wheeler-microfluidics/kicad___dmf_control_board/docs/png/Control board test points (front).png

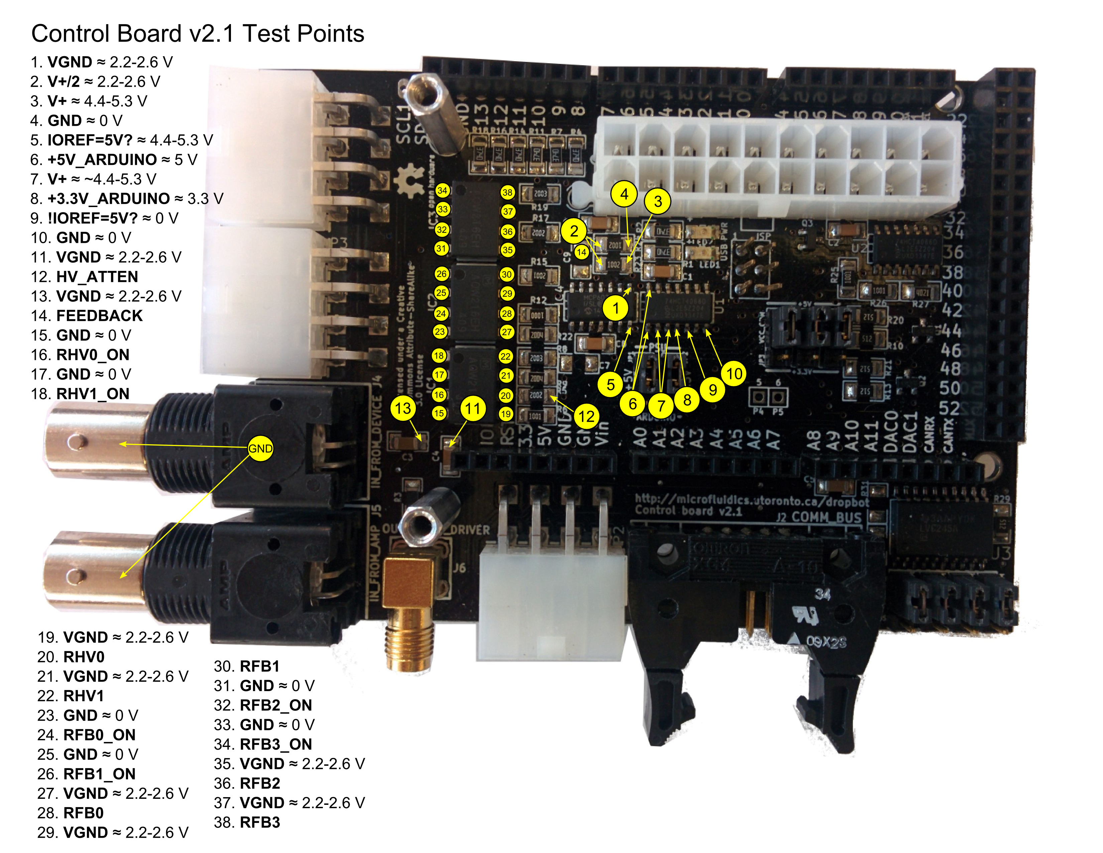
docs/png/Control board test points (front).png
