wheeler-microfluidics/kicad___dmf_control_board/docs/src/control board photo.jpg

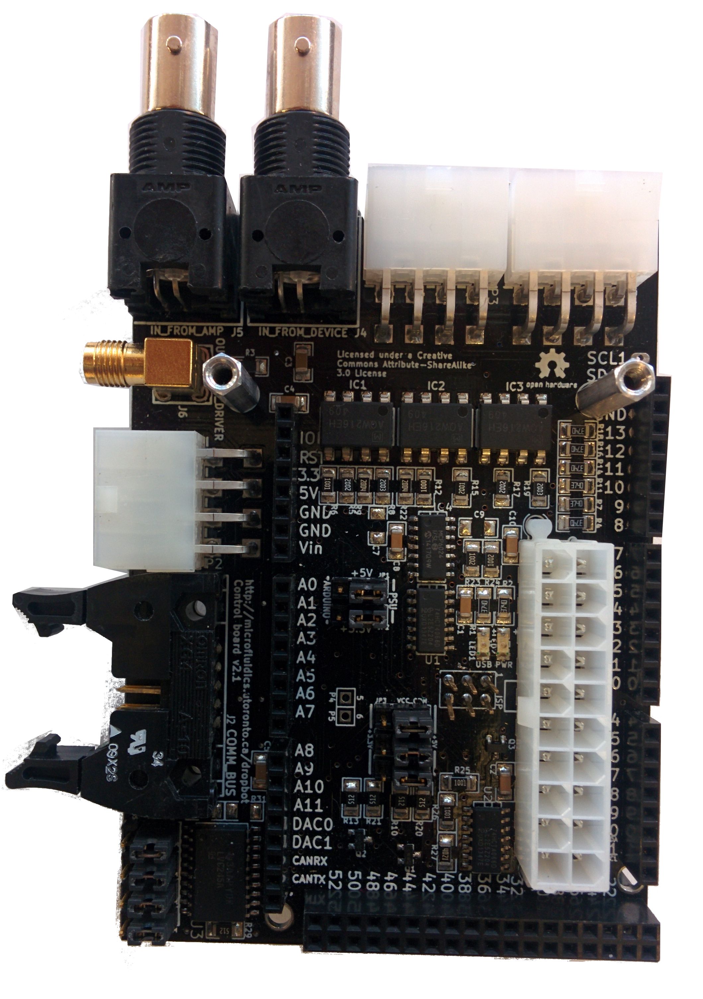
docs/src/control board photo.jpg
