wheeler-microfluidics/kicad___dmf_control_board/docs/Control board v2.1 documentation.odt

Control board v2.1

http://microfluidics.utoronto.ca/trac/dropbot/wiki/ControlBoard

Document revision: 3

Last updated: 2015-03-17
