wheeler-microfluidics/kicad___dmf_control_board/docs/png/Control board layout (back).png

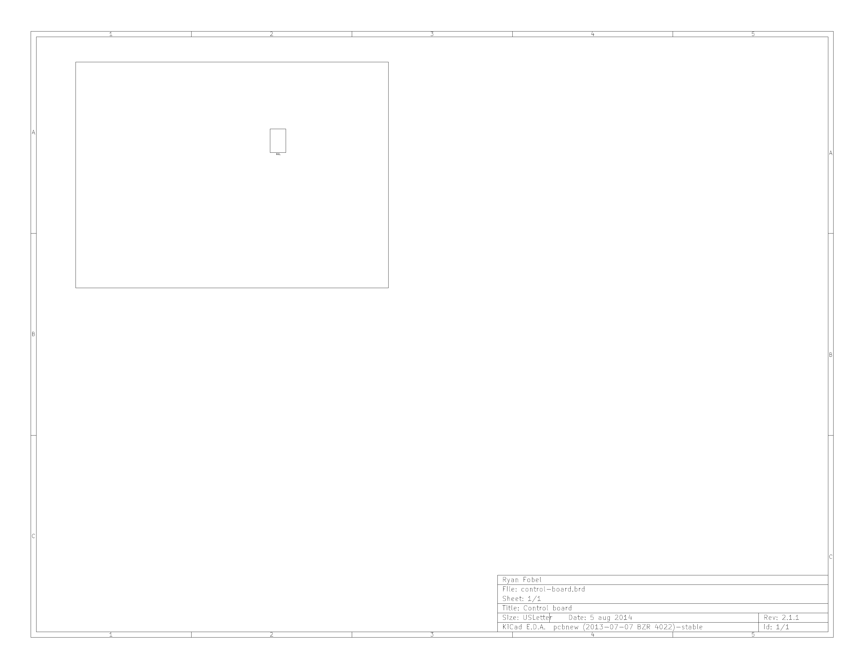
docs/png/Control board layout (back).png
