wheeler-microfluidics/kicad___dmf_control_board/docs/png/Control board layout (front).png

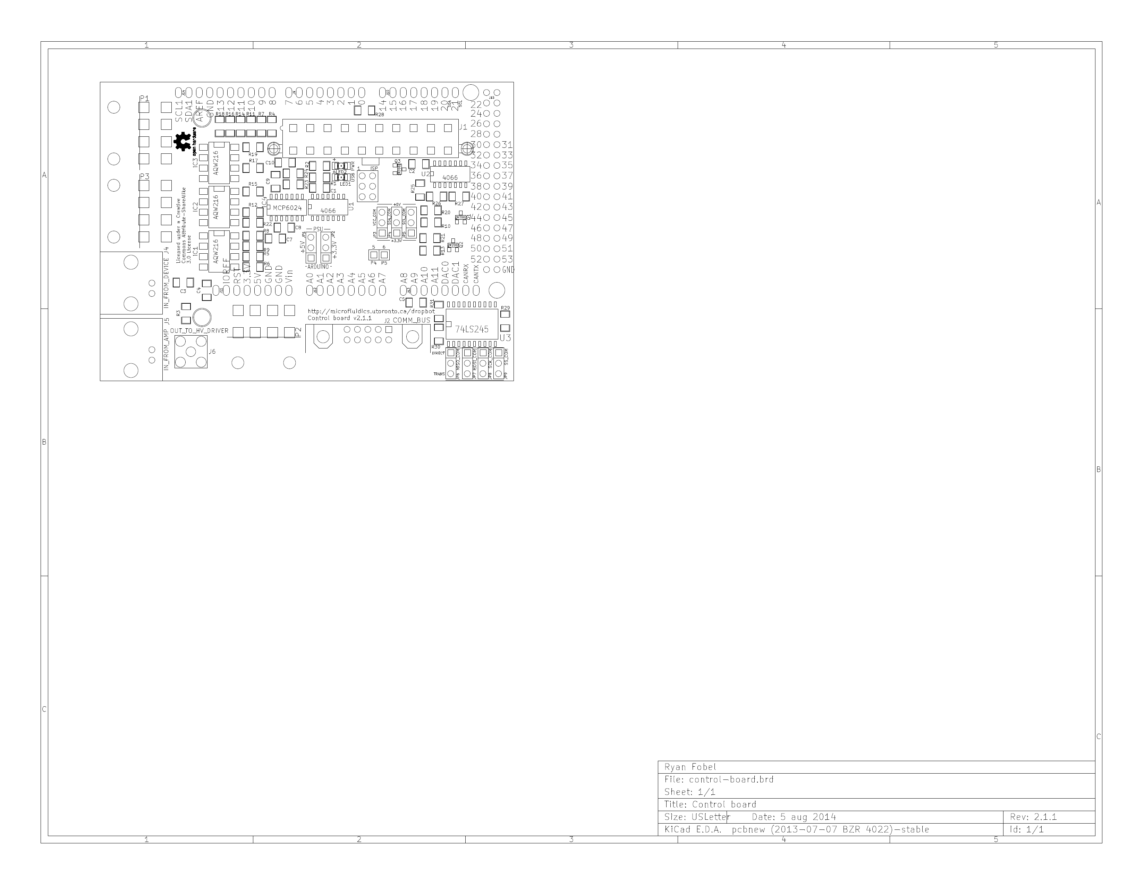
docs/png/Control board layout (front).png
