wheeler-microfluidics/kicad___dmf_control_board/docs/png/Control board schematic (p2).png

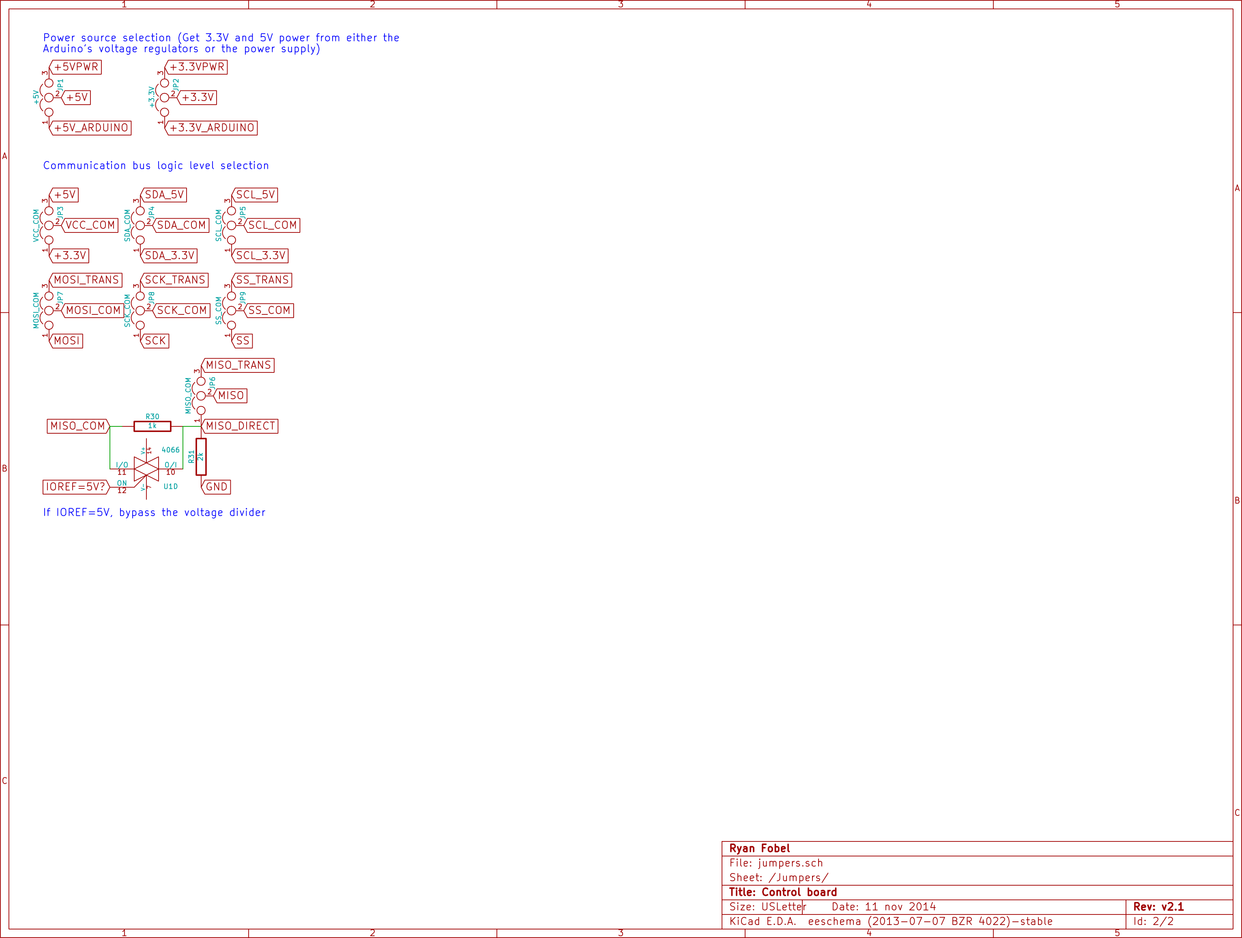
docs/png/Control board schematic (p2).png
