wheeler-microfluidics/kicad___dmf_control_board/docs/png/control-board-BOM.png

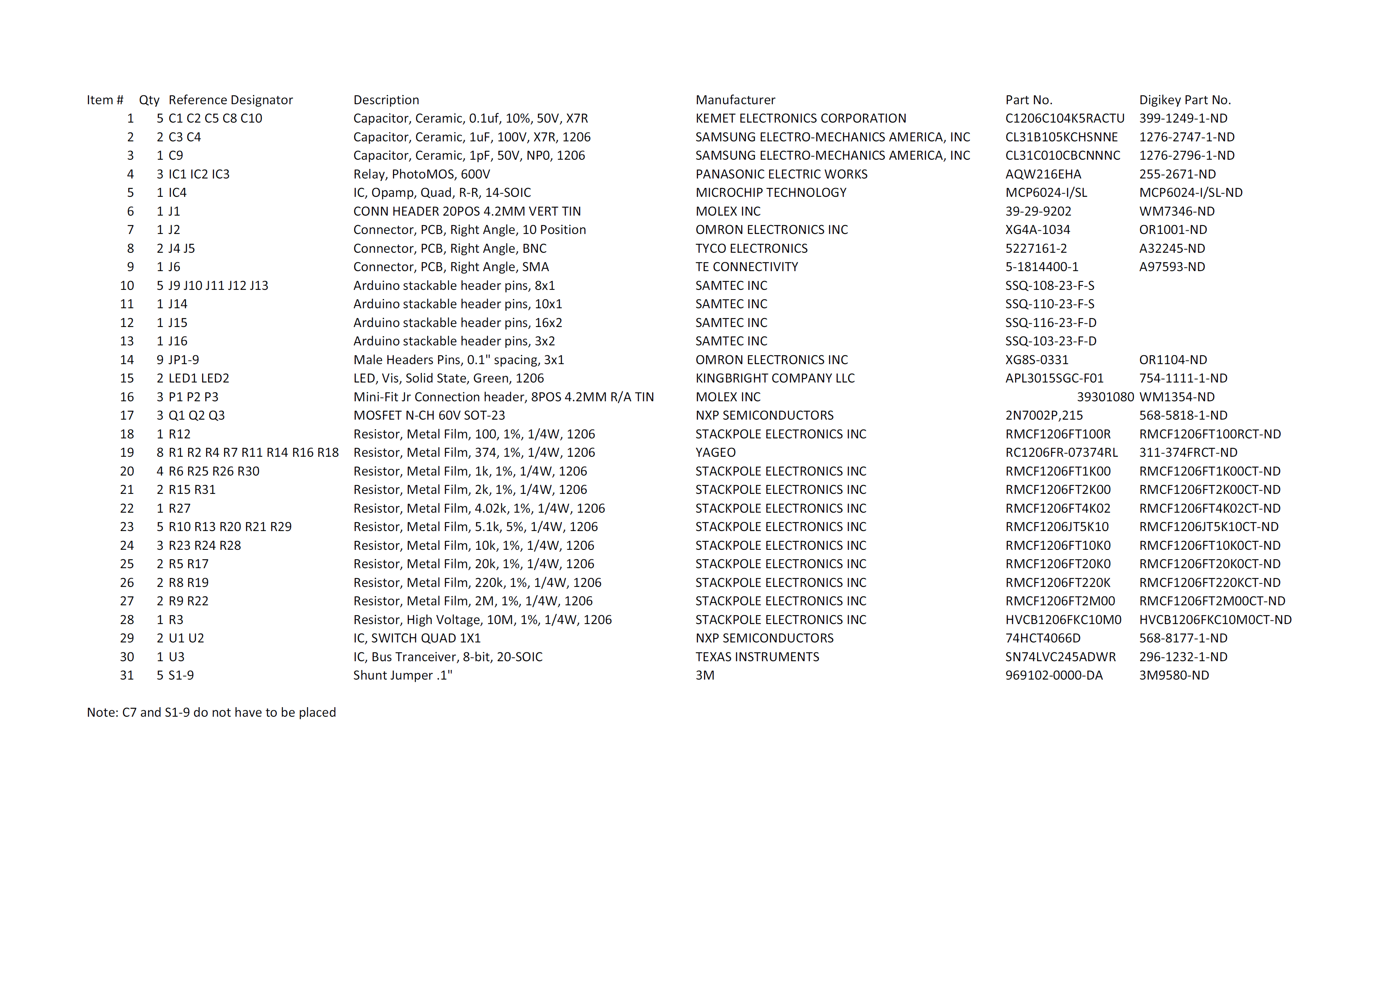
docs/png/control-board-BOM.png
