wheeler-microfluidics/kicad___dmf_control_board/docs/src/Control board layout (back).pdf

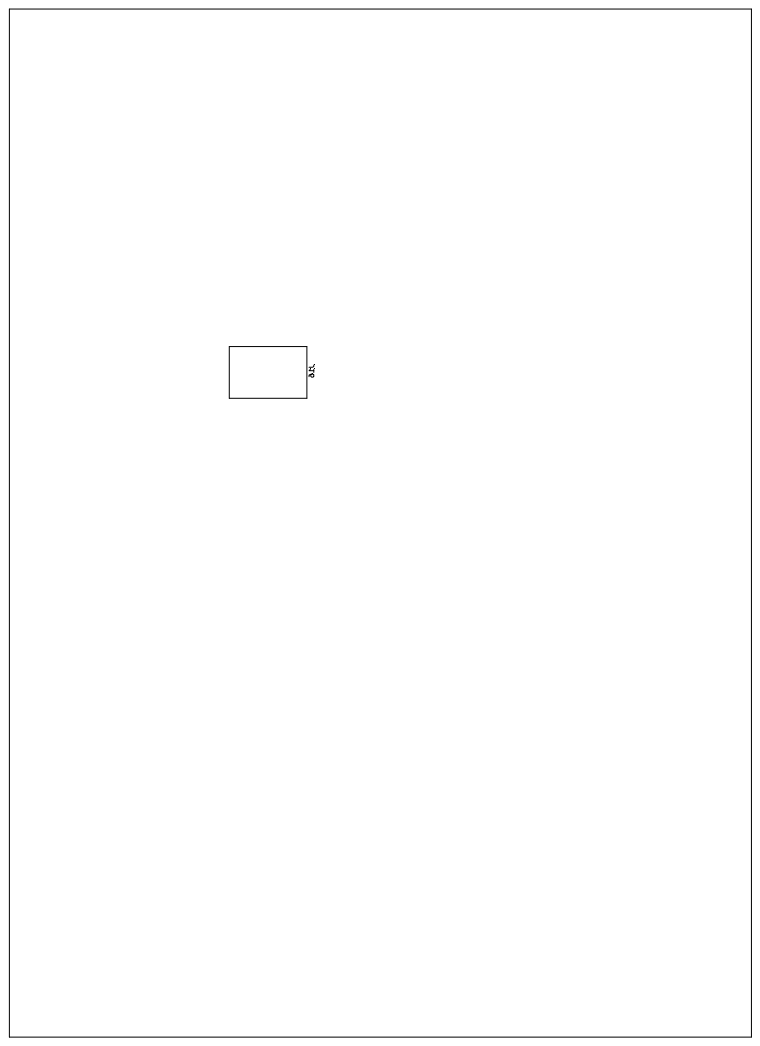
[picture p8: page 1]
