wheeler-microfluidics/kicad___dmf_control_board/docs/src/Control board layout (front).pdf

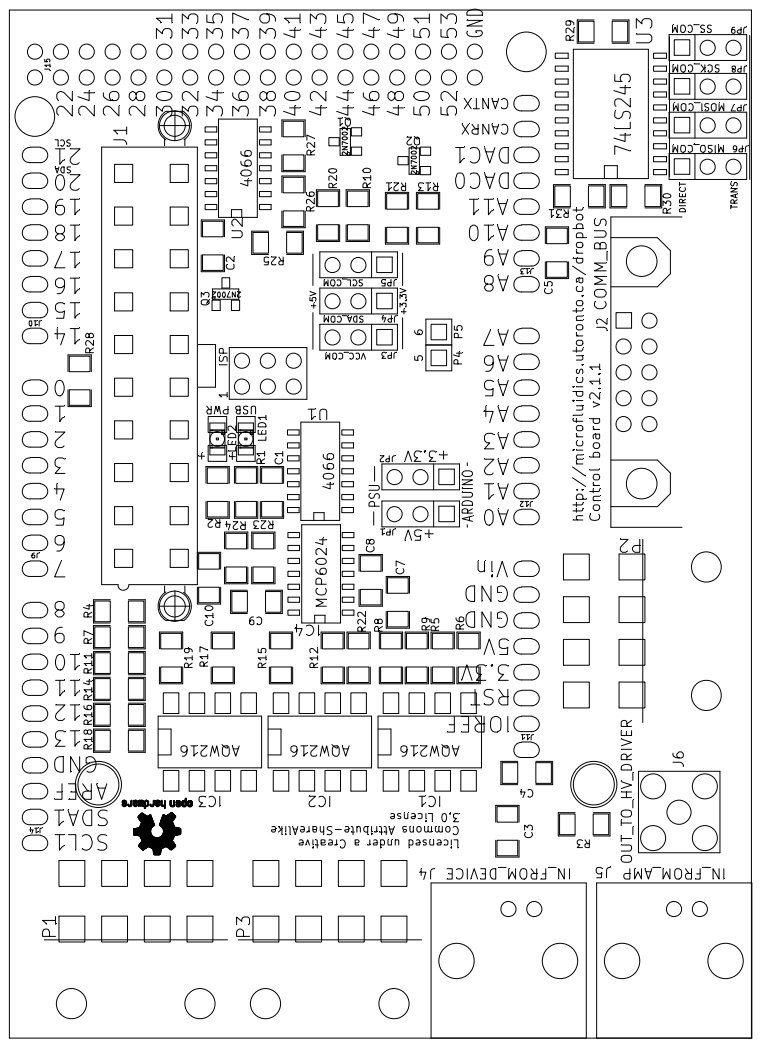
[picture p9: page 1]
