wheeler-microfluidics/kicad___dmf_control_board/control-board.sch

## KiCad design control-board.sch (2014-11-11, an earlier design)

Schematic: control-board.sch

Parts:
C1, C2, C5, C8, C10: 0.1uF
C3, C4: 1uF
C7: 5pF
C9: 1pF
IC1, IC2, IC3: AQW216
IC4: MCP6024
J1: CONN_20
J2: COMM_BUS
J4: IN_FROM_DEVICE
J5: IN_FROM_AMP
J6: OUT_TO_HV_DRIVER
LED1: USB
LED2: PWR
P1, P2, P3: CONN_8
P4: 5
P5: 6
Q1, Q2, Q3: 2N7002; SOT323
R1, R2, R4, R7, R11, R14, R16, R18: 374
R3: 10Meg
R5, R17: 20k
R6, R25, R26: 1k
R8, R19: 200k
R9, R22: 2Meg
R10, R13, R20, R21, R29: 5.1k
R12: 100
R15: 2k
R23, R24, R28: 10k
R27: 4k
SHIELD1: ARDUINO_DUE_SHIELD
U1, U2: 4066
U3: 74LS245

Notes on the sheet:
Power supply connection
BNC connections
600V resistor
Feedback resistor selection
Communication bus
Arduino Mega 2560/Due
Power bus
i2c level shifting
Jumpers
If IOREF > 4V, assume +5V, otherwise, +3.3V logic levels
SPI level shifting
