wheeler-microfluidics/kicad___dmf_control_board/jumpers.sch

## KiCad design jumpers.sch (2014-11-11, an earlier design)

Schematic: jumpers.sch

Parts:
JP1: +5V
JP2: +3.3V
JP3: VCC_COM
JP4: SDA_COM
JP5: SCL_COM
JP6: MISO_COM
JP7: MOSI_COM
JP8: SCK_COM
JP9: SS_COM
R30: 1k
R31: 2k
U1: 4066

Notes on the sheet:
Power source selection (Get 3.3V and 5V power from either the Arduino's voltage regulators or the power supply)
Communication bus logic level selection
If IOREF=5V, bypass the voltage divider
