wheeler-microfluidics/kicad___dmf_control_board/(commit log)

2011-03-15 version 1.0
    [control-board BOM.xls, control-board.brd, control-board.sch]
2011-05-14 Major revision
    -fix several problems with v1.0
    -add peak detector and phase comparator
    -use digipots to set and VGND, AREF
    -allow selection of sine wave or square wave output
    [control-board BOM.xls, control-board-BOM.xls, control-board-p1.sch, control-board-p2.sch, control-board-p3.sch, control-board.brd, control-board.sch]
2011-05-14 Update pdfs.
    [control-board.brd]
2011-05-14 Add extra BNC jack to connect HV driver board
    [control-board-BOM.xls, control-board-p1.sch, control-board-p2.sch, control-board-p3.sch, control-board.brd, control-board.sch]
2011-06-01 Add C22 and C23 to BOM
    [control-board-BOM.xls]
2011-06-01 Upgrade to new version of Kicad and make diodes visible on silkscreen
    [control-board-p1.sch, control-board-p2.sch, control-board-p3.sch, control-board.brd, control-board.sch]
2011-06-01 Change 10-pin connector to a right-angle version
    [control-board-BOM.xls]
2011-07-27 Fix footprint of LM339
    [control-board-p1.sch, control-board-p2.sch, control-board-p3.sch, control-board.brd, control-board.sch]
2011-11-21 Add ATX power supply connector and mounting holes
    [control-board-BOM.xls, control-board-p1.sch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]
2011-12-16 Fix BOM (PhotoMOS part number was wrong)
    [control-board-BOM.xls]
2012-05-15 Minor adjustments to optimize performance and reduce noise
    -remove peak, phase detectors
    -remove adjustable AREF
    -remove power resistors
    -remove monitoring of WAVEOUT
    -remove bias current compensation resistors
    -try to reduce capacitance of HV and feedback traces
    [control-board-BOM.xls, control-board-p1.sch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]
2013-08-26 Lots of changes from v1 series
    -use new communication and power busses
    -break out signal generator onto separate board
    -new feedback scheme
    -jumpers to power from Arduino or PSU
    -automatically select Arduino Mega 2560 or Due (3.3V) including
    level-shifting of i2c
    [control-board-B_Mask.gbs, control-board-B_SilkS.gbo, control-board-Component.gtl, control-board-Copper.gbl, control-board-Edge_Cuts.gbr, control-board-F_Mask.gts, control-board-F_SilkS.gto, control-board-Mask_Back.gbs]
2013-08-26 Swap 2N7000 for 2N7002 and add decoupling caps to 4066s
    Also, make the power plugs extend further from the case
    [control-board-BOM.xls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]
2013-08-27 Fix submodule path
    [control-board.brd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]
2013-08-29 Fix BOM
    [control-board-BOM.xls, control-board.brd]
2013-09-11 Add pos and paste files
    [control-board.brd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]
2013-09-19 Make drill file compatible with gerbmerge
    [control-board.drl]
2014-01-13 Add reference designators for arduino headers and add notes to BOM
    [control-board-BOM.xls, control-board.brd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]
2014-01-16 Route +5V SDA and SCL to communication bus
    [control-board.brd, control-board.sch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]
2014-02-04 Update communication bus
    Add jumpers to select i2c voltage and connect SPI wires to communication bus.
    [control-board-BOM.xls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]
2014-05-08 Add SPI level shifting, replace 0603 caps, ...
    * Add polarity labels to LEDs
    * label jumper pins
    [control-board-B_Mask.gbs, control-board-B_Paste.gbp, control-board-B_SilkS.gbo, control-board-Component.gtl, control-board-Copper.gbl, control-board-Edge_Cuts.gbr, control-board-F_Mask.gts, control-board-F_Paste.gtp]
2014-07-03 Fix BOM and labels
    [control-board-BOM.csv, control-board-BOM.xls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]
2014-07-16 Replace wrong SMA jack on BOM
    [control-board-BOM.csv]
2014-07-24 Add C9 to BOM (and change to 1pF)
    [control-board-BOM.csv, control-board.sch, jumpers.sch]
2014-07-24 Put BOM in format for gold phoenix
    [control-board-BOM.csv]
2014-08-05 Fix VCC/+3.3V short, add pos files
    [control-board.brd, control-board.sch, jumpers.sch]
2014-11-11 Replace R8 and R19 with 220k resistors
    Because the 200k resistors are in parallel with a 2M resistor when connected,
    the combined resistance is 1/(1/2e6 + 1/2e5)=182k. With the new 220k resistors,
    the combined resistance is 198k which is closer to the intended 1/10 ratio
    between gain steps. There should be no major change in function.
    [control-board-BOM.csv, control-board.sch, jumpers.sch]
2015-02-04 Fix part numbers on BOM and add link to header kit
    [control-board-BOM.csv]
2015-02-24 Add BNC nuts and lock washers to BOM
    [control-board-BOM.csv]
2015-03-17 Update gerber files to v2.1.1
    [control-board-Component.gtl, control-board-Copper.gbl, control-board-F_SilkS.gto]
